deb0ro/ventaxia-esphome/hardware/mvhr_ctrl/J1_pinout_top.png

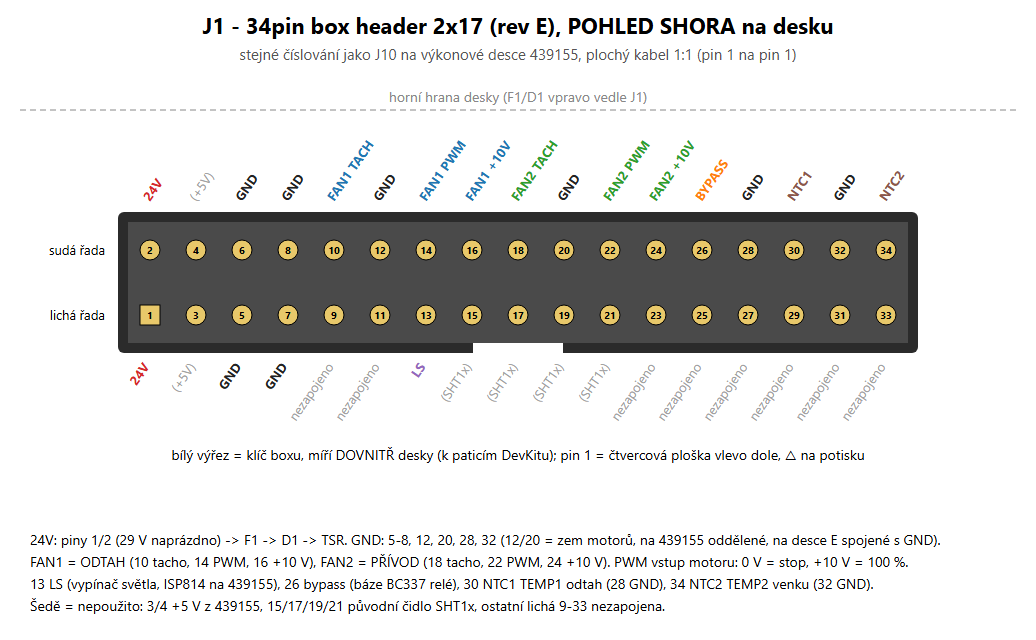
hardware/mvhr_ctrl/J1_pinout_top.png
