deb0ro/ventaxia-esphome/hardware/mvhr_ctrl/render_bottom.png

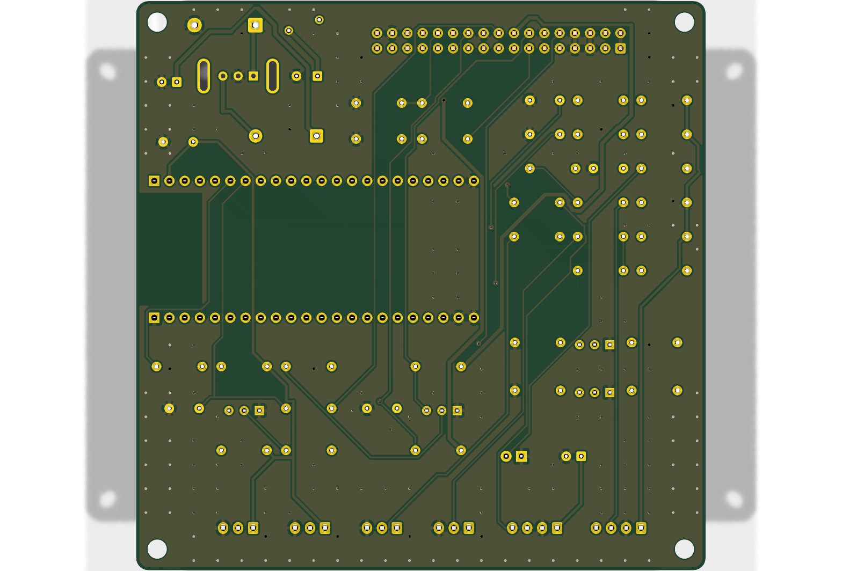
hardware/mvhr_ctrl/render_bottom.png
