deb0ro/ventaxia-esphome/hardware/mvhr_ctrl/mvhr_ctrl_bom.csv

Reference | Value | Footprint | MPN | Qty
C1 | 10u/100V | Capacitor_THT:CP_Radial_D8.0mm_P3.50mm | Electrolytic 10 uF 100 V, D8 P3.5 | 1
C2 | 47u/16V | Capacitor_THT:CP_Radial_D6.3mm_P2.50mm |  | 1
C3,C13-C15 | 100n | Capacitor_THT:C_Disc_D5.0mm_W2.5mm_P5.00mm |  | 4
C5 | 100u/10V | Capacitor_THT:CP_Radial_D6.3mm_P2.50mm |  | 1
C21,C41 | 1n | Capacitor_THT:C_Disc_D5.0mm_W2.5mm_P5.00mm |  | 2
D1 | P6KE47CA | Diode_THT:D_DO-15_P10.16mm_Horizontal | P6KE47CA (40.2 V standoff, 64.8 V clamp) | 1
D2 | 1N5819 | Diode_THT:D_DO-41_SOD81_P10.16mm_Horizontal |  | 1
D3 | red 3 mm | LED_THT:LED_D3.0mm |  | 1
F1 | RXEF030 | Fuse:Fuse_BelFuse_0ZRE0033FF_L11.4mm_W3.8mm | Littelfuse RXEF030 (72 V, hold 0.30 A / trip 0.60 A @ 20 C), alt. Bel Fuse 0ZRE0033FF1A | 1
J1 | IDC 2x17 -> 439155 J10 | Connector_IDC:IDC-Header_2x17_P2.54mm_Vertical | Box header 2x17 2.54mm | 1
J2 | DevKit J1 (left) | Connector_PinSocket_2.54mm:PinSocket_1x22_P2.54mm_Vertical | Female header 1x22 2.54 mm | 1
J3 | DevKit J3 (right) | Connector_PinSocket_2.54mm:PinSocket_1x22_P2.54mm_Vertical | Female header 1x22 2.54 mm | 1
J4 | OUTDOOR | Connector_JST:JST_XH_B3B-XH-A_1x03_P2.50mm_Vertical | JST B3B-XH-A | 1
J5 | SUPPLY | Connector_JST:JST_XH_B3B-XH-A_1x03_P2.50mm_Vertical | JST B3B-XH-A | 1
J6 | EXTRACT | Connector_JST:JST_XH_B3B-XH-A_1x03_P2.50mm_Vertical | JST B3B-XH-A | 1
J7 | EXHAUST | Connector_JST:JST_XH_B3B-XH-A_1x03_P2.50mm_Vertical | JST B3B-XH-A | 1
J8 | Humidity SHT4x (0x44) | Connector_JST:JST_XH_B4B-XH-A_1x04_P2.50mm_Vertical | JST B4B-XH-A | 1
J9 | CO2 SCD41 (0x62) | Connector_JST:JST_XH_B4B-XH-A_1x04_P2.50mm_Vertical | JST B4B-XH-A | 1
Q1-Q4 | PN2222A | Package_TO_SOT_THT:TO-92_Inline_Wide | onsemi PN2222A (TO-92, pins E-B-C = 1-2-3, flat side as on the silkscreen) | 4
R7,R8,R61-R64 | 100 | Resistor_THT:R_Axial_DIN0207_L6.3mm_D2.5mm_P7.62mm_Horizontal |  | 6
R9-R11,R19,R24,R44 | 1k | Resistor_THT:R_Axial_DIN0207_L6.3mm_D2.5mm_P7.62mm_Horizontal |  | 6
R12,R13,R15,R16,R23,R25,R43,R45 | 10k | Resistor_THT:R_Axial_DIN0207_L6.3mm_D2.5mm_P7.62mm_Horizontal |  | 8
R14,R21,R41 | 22k | Resistor_THT:R_Axial_DIN0207_L6.3mm_D2.5mm_P7.62mm_Horizontal |  | 3
R17,R18,R20,R22,R40,R42,R60 | 4k7 | Resistor_THT:R_Axial_DIN0207_L6.3mm_D2.5mm_P7.62mm_Horizontal |  | 7
U1 | TSR 1-4850WI | mvhr_ctrl:TRACO_TSR-1WI_SIP3_CasePins | TRACO TSR 1-4850WI, straight pins (9-72 V in, 5 V 1 A); case pins 4/5 = mechanical, no net | 1
