deb0ro/ventaxia-esphome/hardware/mvhr_ctrl/mvhr_ctrl_assembly.pdf

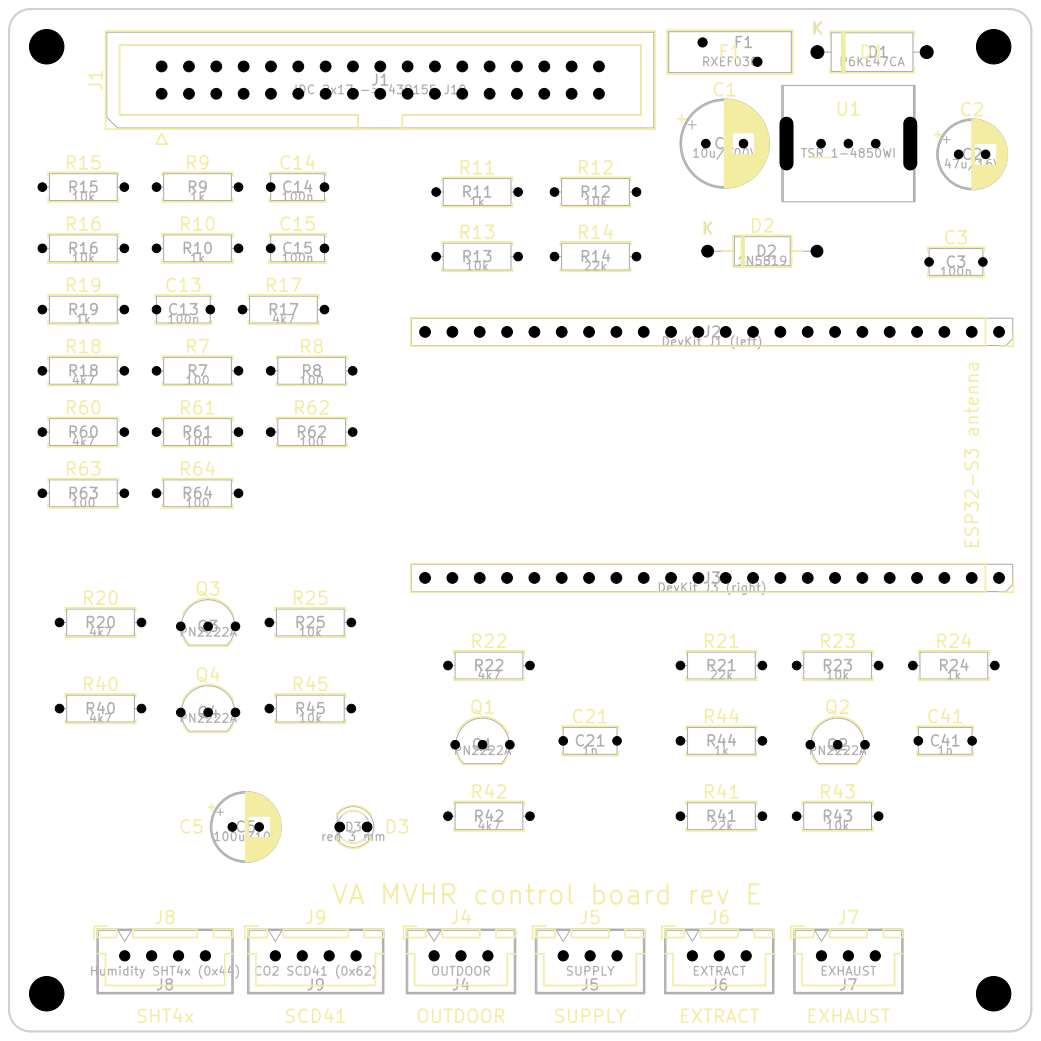
[picture p6: page 1]

VA MVHR control board rev E

Sheet:
File: mvhr_ctrl.kicad_pcb
Title: VA MVHR control board

Size: A4 | Rev: E
KiCad E.D.A. 10.0.7 | Id: 1/1
