deb0ro/ventaxia-esphome/hardware/mvhr_ctrl/mvhr_ctrl.kicad_pcb

## KiCad design hardware/mvhr_ctrl/mvhr_ctrl.kicad_pcb (2026-11-09)

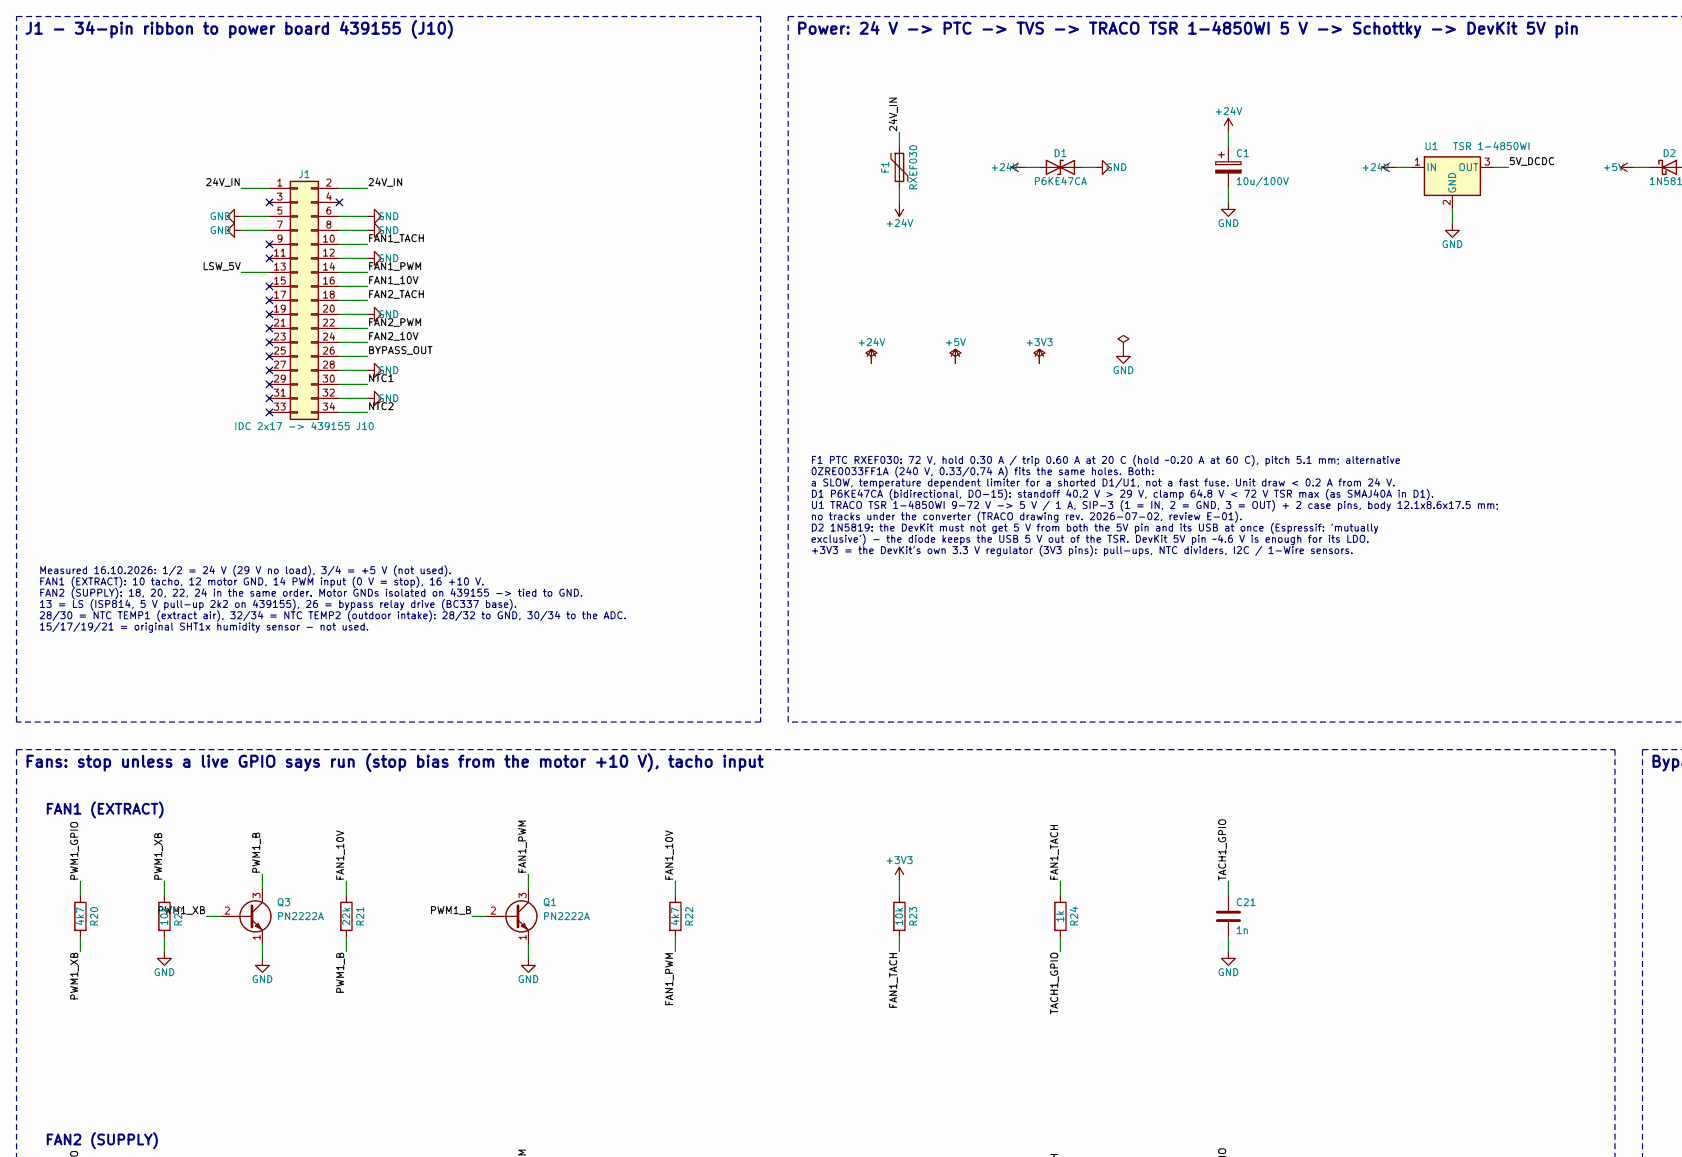
[picture p8: schematic mvhr_ctrl.kicad_sch, MVHR control board - ESP32-S3-DevKitC-1, through-hole, part in row 1, column 1]

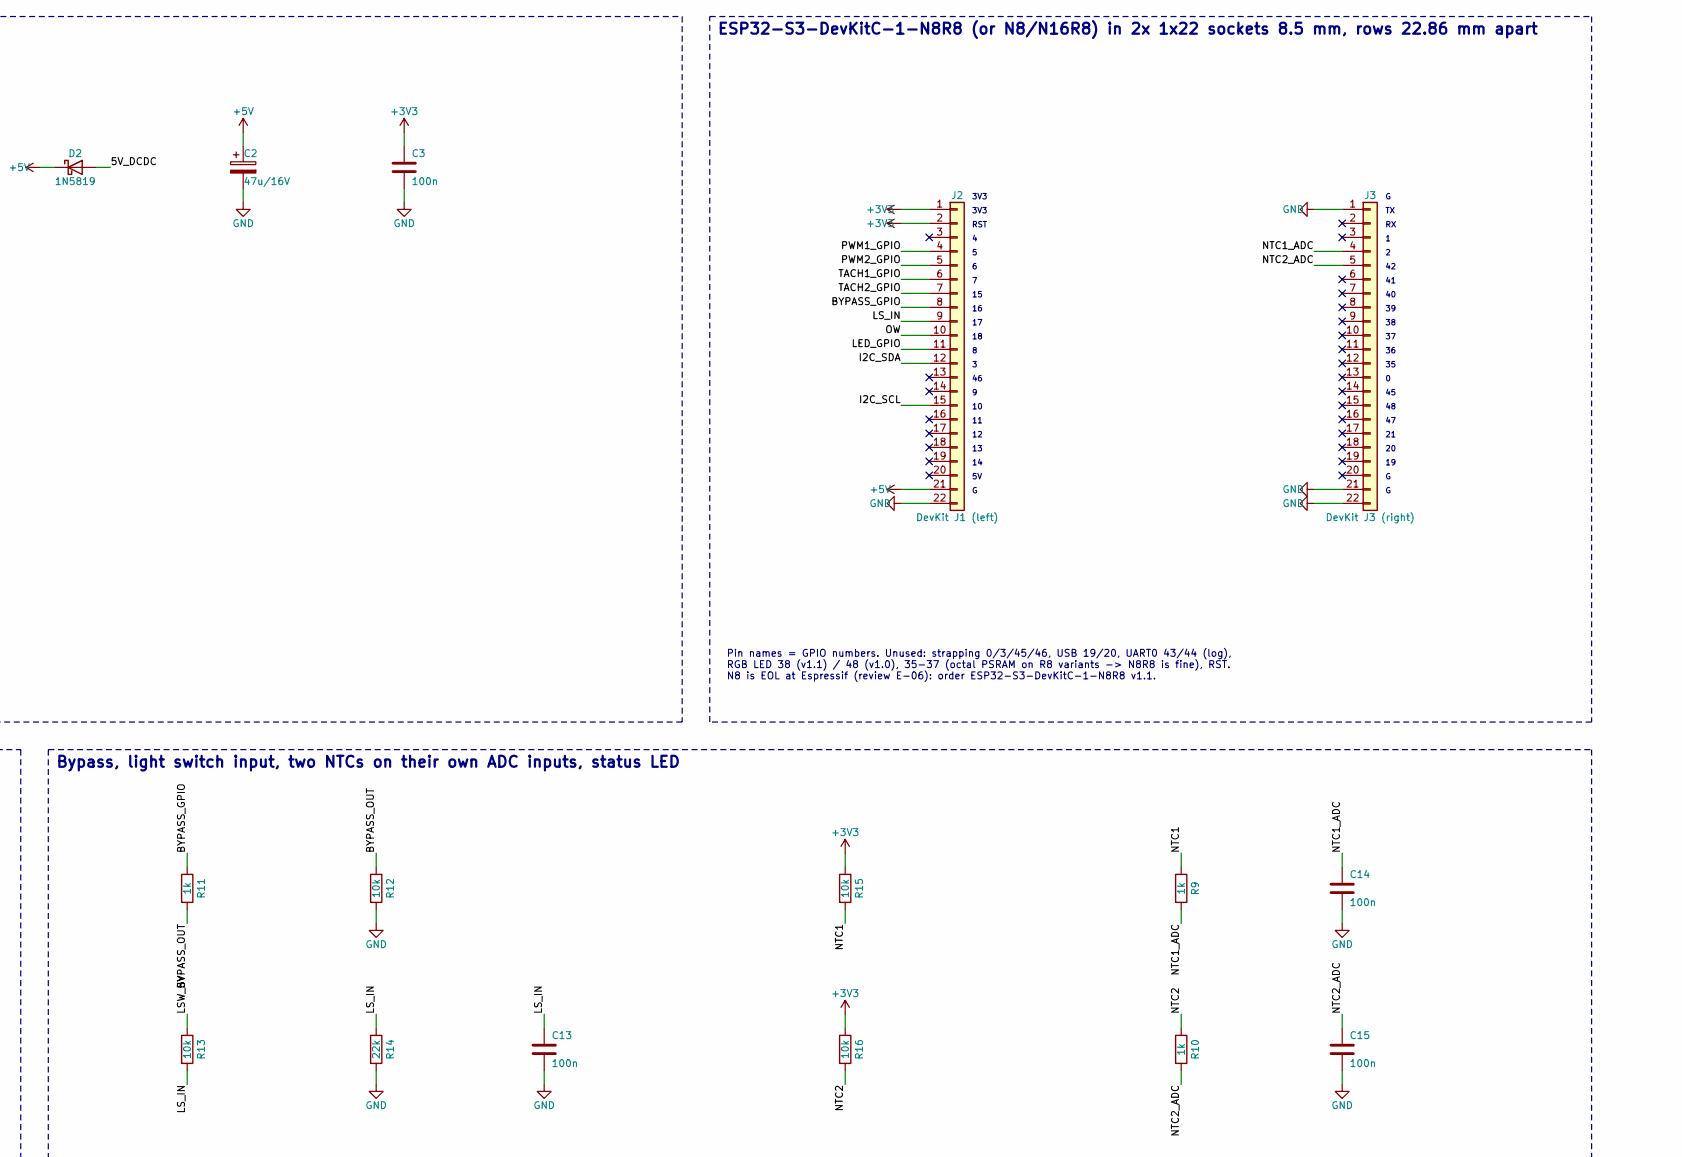
[picture p9: schematic mvhr_ctrl.kicad_sch, MVHR control board - ESP32-S3-DevKitC-1, through-hole, part in row 1, column 2]

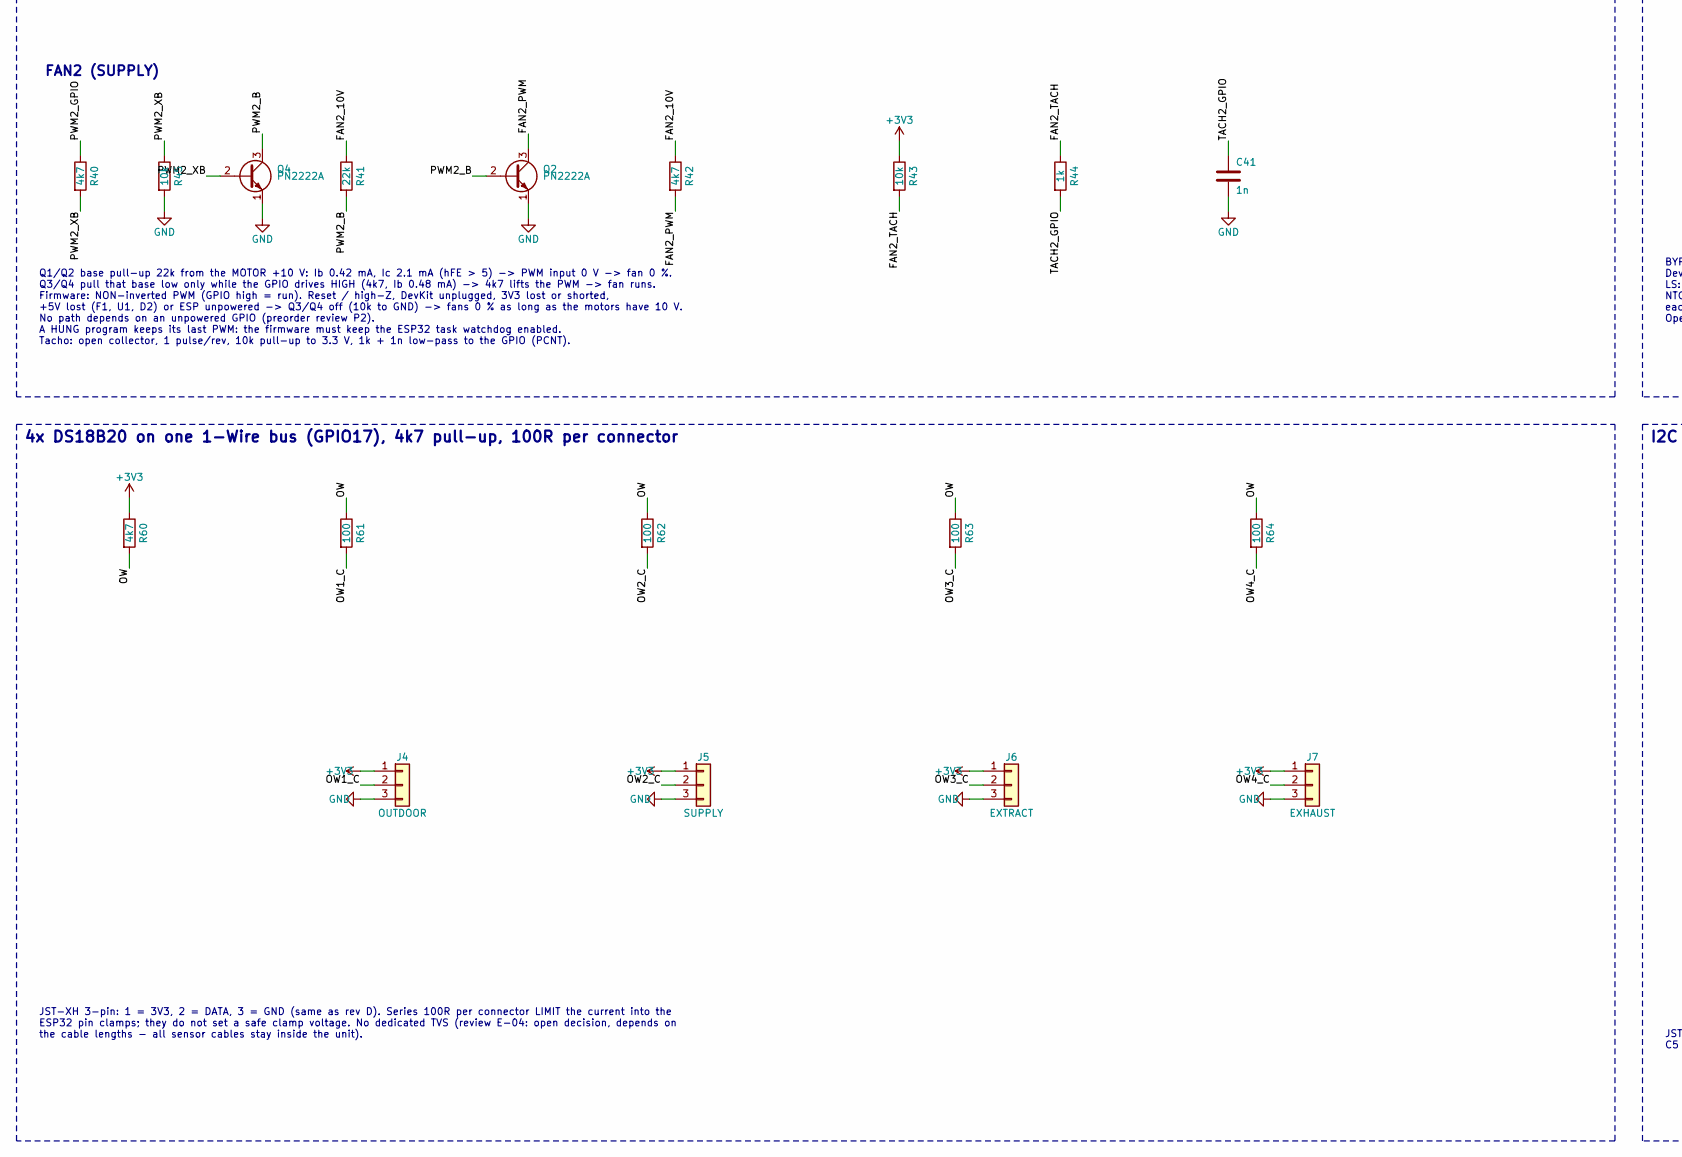
[picture p10: schematic mvhr_ctrl.kicad_sch, MVHR control board - ESP32-S3-DevKitC-1, through-hole, part in row 2, column 1]

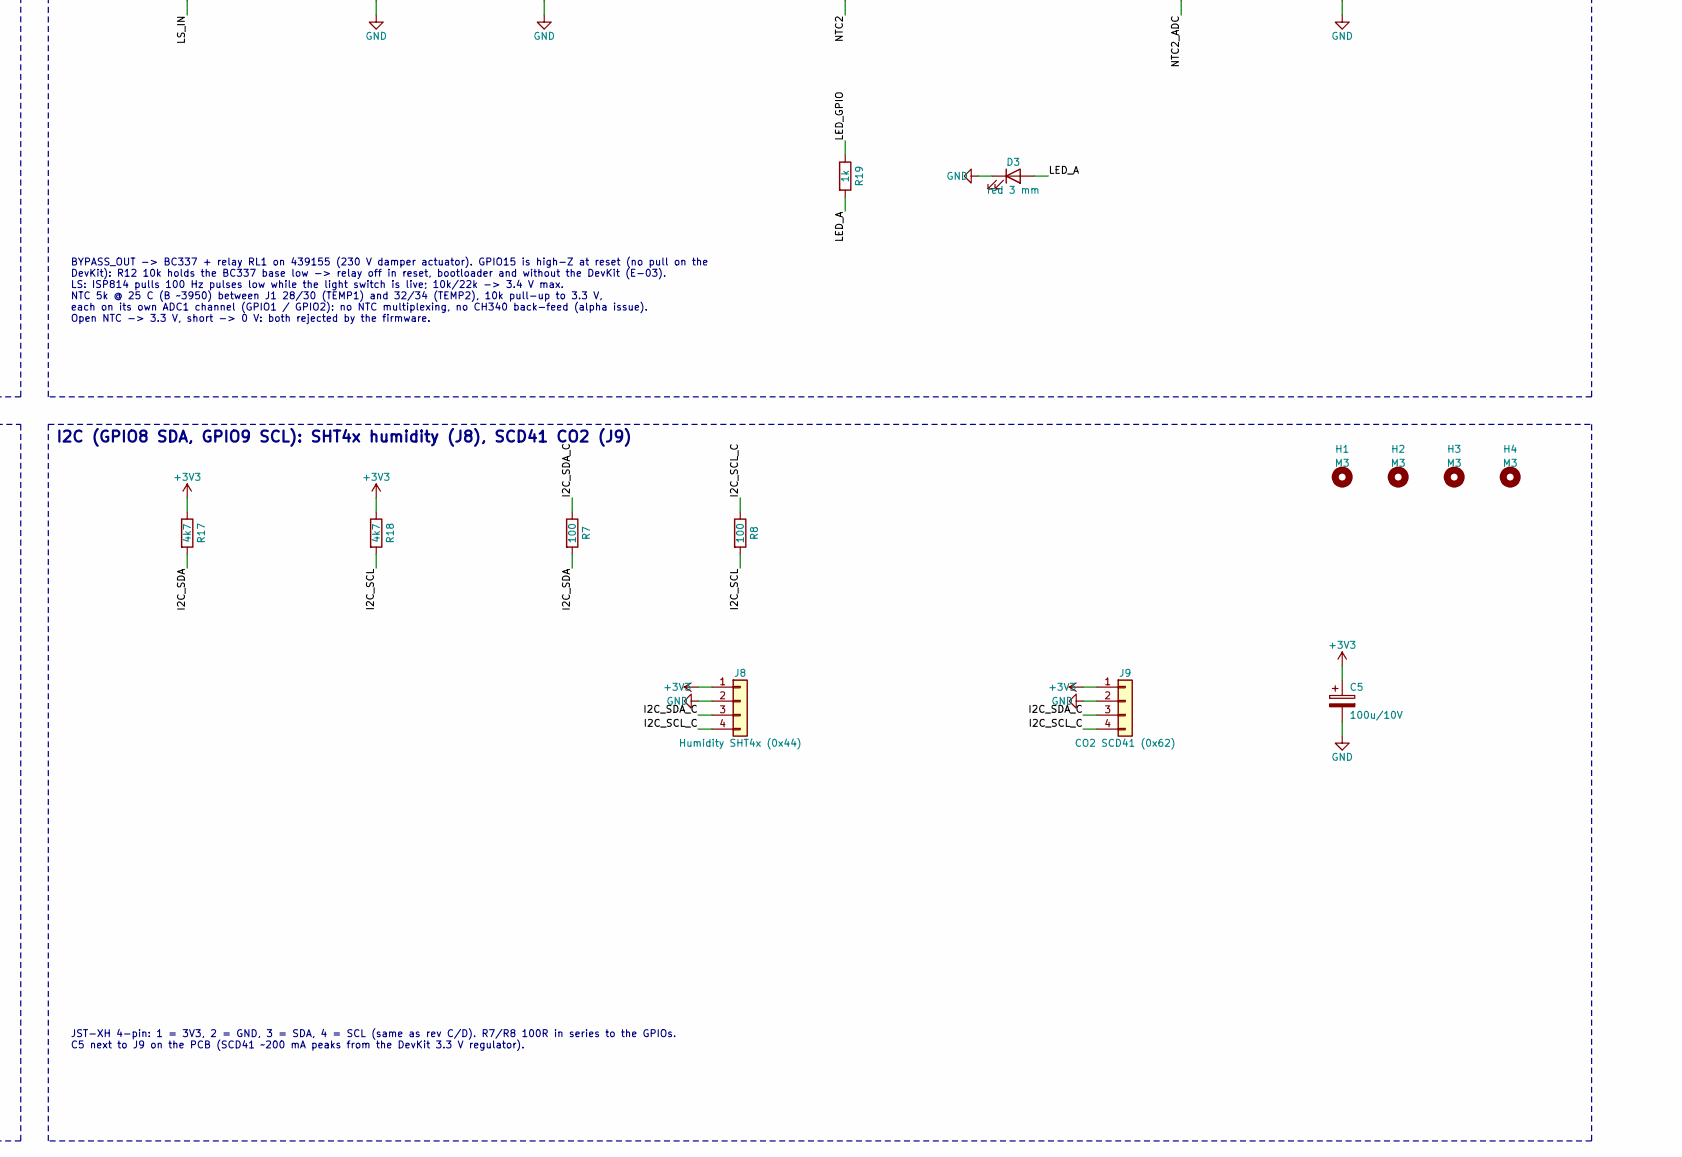
[picture p11: schematic mvhr_ctrl.kicad_sch, MVHR control board - ESP32-S3-DevKitC-1, through-hole, part in row 2, column 2]

Parts:
C1: 10u/100V; CP_Radial_D8.0mm_P3.50mm; MPN Electrolytic 10 uF 100 V, D8 P3.5
C2: 47u/16V; CP_Radial_D6.3mm_P2.50mm
C3, C13, C14, C15: 100n; C_Disc_D5.0mm_W2.5mm_P5.00mm
C5: 100u/10V; CP_Radial_D6.3mm_P2.50mm
C21, C41: 1n; C_Disc_D5.0mm_W2.5mm_P5.00mm
D1: P6KE47CA; D_DO-15_P10.16mm_Horizontal; MPN P6KE47CA (40.2 V standoff, 64.8 V clamp)
D2: 1N5819; D_DO-41_SOD81_P10.16mm_Horizontal
D3: red 3 mm; LED_D3.0mm
F1: RXEF030; Fuse_BelFuse_0ZRE0033FF_L11.4mm_W3.8mm; MPN Littelfuse RXEF030 (72 V, hold 0.30 A /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
H1, H2, H3, H4: M3; MountingHole_3.2mm_M3
J1: IDC 2x17 -> 439155 J10; IDC-Header_2x17_P2.54mm_Vertical; MPN Box header 2x17 2.54mm
J2: DevKit J1 (left); PinSocket_1x22_P2.54mm_Vertical; MPN Female header 1x22 2.54 mm
J3: DevKit J3 (right); PinSocket_1x22_P2.54mm_Vertical; MPN Female header 1x22 2.54 mm
J4: OUTDOOR; JST_XH_B3B-XH-A_1x03_P2.50mm_Vertical; MPN JST B3B-XH-A
J5: SUPPLY; JST_XH_B3B-XH-A_1x03_P2.50mm_Vertical; MPN JST B3B-XH-A
J6: EXTRACT; JST_XH_B3B-XH-A_1x03_P2.50mm_Vertical; MPN JST B3B-XH-A
J7: EXHAUST; JST_XH_B3B-XH-A_1x03_P2.50mm_Vertical; MPN JST B3B-XH-A
J8: Humidity SHT4x (0x44); JST_XH_B4B-XH-A_1x04_P2.50mm_Vertical; MPN JST B4B-XH-A
J9: CO2 SCD41 (0x62); JST_XH_B4B-XH-A_1x04_P2.50mm_Vertical; MPN JST B4B-XH-A
Q1, Q2, Q3, Q4: PN2222A; TO-92_Inline_Wide; MPN onsemi PN2222A (TO-92, pins E-B-C = 1-2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
R7, R8, R61, R62, R63, R64: 100; R_Axial_DIN0207_L6.3mm_D2.5mm_P7.62mm_Horizontal
R9, R10, R11, R19, R24, R44: 1k; R_Axial_DIN0207_L6.3mm_D2.5mm_P7.62mm_Horizontal
R12, R13, R15, R16, R23, R25, R43, R45: 10k; R_Axial_DIN0207_L6.3mm_D2.5mm_P7.62mm_Horizontal
R14, R21, R41: 22k; R_Axial_DIN0207_L6.3mm_D2.5mm_P7.62mm_Horizontal
R17, R18, R20, R22, R40, R42, R60: 4k7; R_Axial_DIN0207_L6.3mm_D2.5mm_P7.62mm_Horizontal
U1: TSR 1-4850WI; TRACO_TSR-1WI_SIP3_CasePins; MPN TRACO TSR 1-4850WI, straight pins (9-72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

Connections:
+3V3: C3.1, C5.1, J2.1, J2.2, J4.1, J5.1, J6.1, J7.1, J8.1, J9.1, R15.1, R16.1, R17.1, R18.1, R23.1, R43.1, R60.1
+5V: C2.1, D2.1 (K), J2.21
+24V: C1.1, D1.1 (A1), F1.2, U1.1 (IN)
/5V_DCDC: D2.2 (A), U1.3 (OUT)
/24V_IN: F1.1, J1.1, J1.2
/BYPASS_GPIO: J2.8, R11.1
/BYPASS_OUT: J1.26, R11.2, R12.1
/FAN1_10V: J1.16, R21.1, R22.1
/FAN1_PWM: J1.14, Q1.3 (C), R22.2
/FAN1_TACH: J1.10, R23.2, R24.1
/FAN2_10V: J1.24, R41.1, R42.1
/FAN2_PWM: J1.22, Q2.3 (C), R42.2
/FAN2_TACH: J1.18, R43.2, R44.1
/I2C_SCL: J2.15, R8.2, R18.2
/I2C_SCL_C: J8.4, J9.4, R8.1
/I2C_SDA: J2.12, R7.2, R17.2
/I2C_SDA_C: J8.3, J9.3, R7.1
/LED_A: D3.2 (A), R19.2
/LED_GPIO: J2.11, R19.1
/LSW_5V: J1.13, R13.1
/LS_IN: C13.1, J2.9, R13.2, R14.1
/NTC1: J1.30, R9.1, R15.2
/NTC1_ADC: C14.1, J3.4, R9.2
/NTC2: J1.34, R10.1, R16.2
/NTC2_ADC: C15.1, J3.5, R10.2
/OW: J2.10, R60.2, R61.1, R62.1, R63.1, R64.1
/OW1_C: J4.2, R61.2
/OW2_C: J5.2, R62.2
/OW3_C: J6.2, R63.2
/OW4_C: J7.2, R64.2
/PWM1_B: Q1.2 (B), Q3.3 (C), R21.2
/PWM1_GPIO: J2.4, R20.1
/PWM1_XB: Q3.2 (B), R20.2, R25.1
/PWM2_B: Q2.2 (B), Q4.3 (C), R41.2
/PWM2_GPIO: J2.5, R40.1
/PWM2_XB: Q4.2 (B), R40.2, R45.1
/TACH1_GPIO: C21.1, J2.6, R24.2
/TACH2_GPIO: C41.1, J2.7, R44.2
GND: C1.2, C2.2, C3.2, C5.2, C13.2, C14.2, C15.2, C21.2, C41.2, D1.2 (A2), D3.1 (K), J1.5, J1.6, J1.7, J1.8, J1.12, J1.20, J1.28, J1.32, J2.22, J3.1, J3.21, J3.22, J4.3, J5.3, J6.3, J7.3, J8.2, J9.2, Q1.1 (E), Q2.1 (E), Q3.1 (E), Q4.1 (E), R12.2, R14.2, R25.2, R45.2, U1.2 (GND)

Notes on the sheet:
J1 - 34-pin ribbon to power board 439155 (J10)
Measured 16.10.2026: 1/2 = 24 V (29 V no load), 3/4 = +5 V (not used). FAN1 (EXTRACT): 10 tacho, 12 motor GND, 14 PWM input (0 V = stop), 16 +10 V. FAN2 (SUPPLY): 18, 20, 22, 24 in the same order. Motor GNDs isolated on 439155 -> tied to GND. 13 = LS (ISP814, 5 V pull-up 2k2 on 439155), 26 = bypass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
Power: 24 V -> PTC -> TVS -> TRACO TSR 1-4850WI 5 V -> Schottky -> DevKit 5V pin
F1 PTC RXEF030: 72 V, hold 0.30 A / trip 0.60 A at 20 C (hold ~0.20 A at 60 C), pitch 5.1 mm; alternative 0ZRE0033FF1A (240 V, 0.33/0.74 A) fits the same holes. Both: a SLOW, temperature dependent limiter for a shorted D1/U1, not a fast fuse. Unit draw < 0.2 A from 24 V. D1 P6KE47CA (bidirectional,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
ESP32-S3-DevKitC-1-N8R8 (or N8/N16R8) in 2x 1x22 sockets 8.5 mm, rows 22.86 mm apart
3V3
RST
Pin names = GPIO numbers. Unused: strapping 0/3/45/46, USB 19/20, UART0 43/44 (log), RGB LED 38 (v1.1) / 48 (v1.0), 35-37 (octal PSRAM on R8 variants -> N8R8 is fine), RST. N8 is EOL at Espressif (review E-06): order ESP32-S3-DevKitC-1-N8R8 v1.1.
Fans: stop unless a live GPIO says run (stop bias from the motor +10 V), tacho input
FAN1 (EXTRACT)
FAN2 (SUPPLY)
Q1/Q2 base pull-up 22k from the MOTOR +10 V: Ib 0.42 mA, Ic 2.1 mA (hFE > 5) -> PWM input 0 V -> fan 0 %. Q3/Q4 pull that base low only while the GPIO drives HIGH (4k7, Ib 0.48 mA) -> 4k7 lifts the PWM -> fan runs. Firmware: NON-inverted PWM (GPIO high = run). Reset / high-Z, DevKit unplugged, 3V3 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
Bypass, light switch input, two NTCs on their own ADC inputs, status LED
BYPASS_OUT -> BC337 + relay RL1 on 439155 (230 V damper actuator). GPIO15 is high-Z at reset (no pull on the DevKit): R12 10k holds the BC337 base low -> relay off in reset, bootloader and without the DevKit (E-03). LS: ISP814 pulls 100 Hz pulses low while the light switch is live; 10k/22k -> 3.4 V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
4x DS18B20 on one 1-Wire bus (GPIO17), 4k7 pull-up, 100R per connector
JST-XH 3-pin: 1 = 3V3, 2 = DATA, 3 = GND (same as rev D). Series 100R per connector LIMIT the current into the ESP32 pin clamps; they do not set a safe clamp voltage. No dedicated TVS (review E-04: open decision, depends on the cable lengths - all sensor cables stay inside the unit).
I2C (GPIO8 SDA, GPIO9 SCL): SHT4x humidity (J8), SCD41 CO2 (J9)
JST-XH 4-pin: 1 = 3V3, 2 = GND, 3 = SDA, 4 = SCL (same as rev C/D). R7/R8 100R in series to the GPIOs. C5 next to J9 on the PCB (SCD41 ~200 mA peaks from the DevKit 3.3 V regulator).

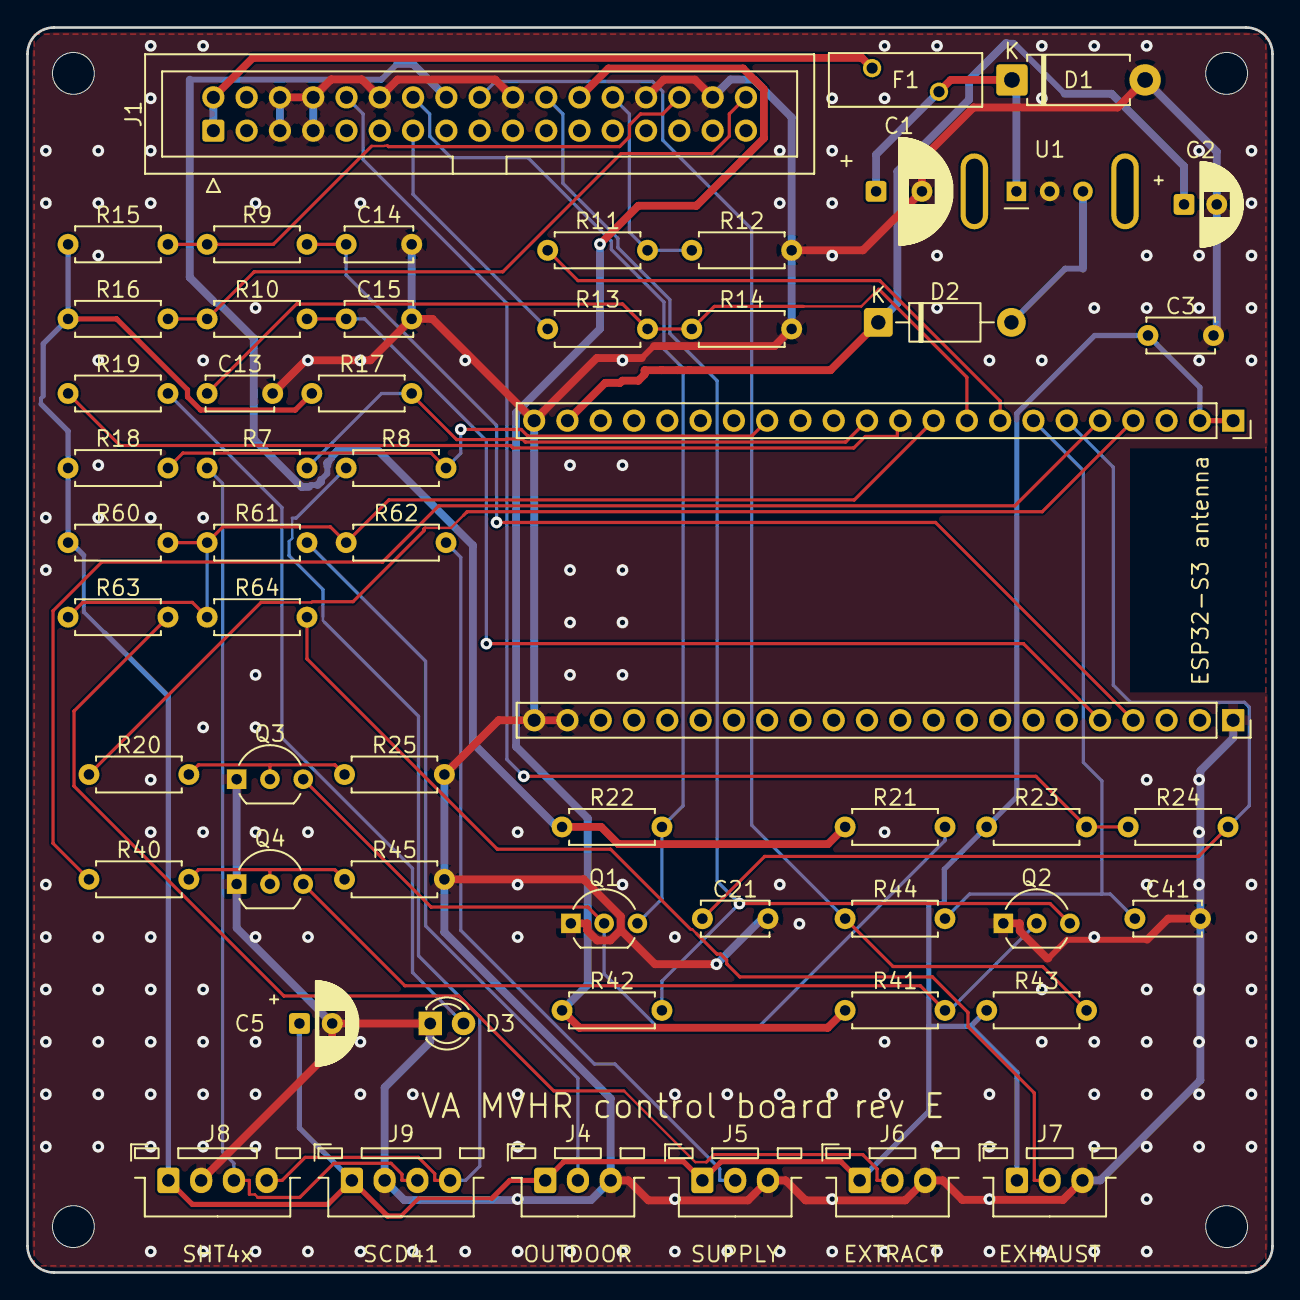
[picture p12: board mvhr_ctrl.kicad_pcb from above]

Board: 2 copper layers, 95.0 x 95.0 mm, 61 parts (0 on the bottom side), 39 nets.
