deb0ro/ventaxia-esphome/firmware/gen/reve.py

# Rev E hardware layer for gen_fw.py: turns the shared template (control logic of the alpha, all review fixes)
# into hw/firmware/ventaxia_reve.yaml for the MVHR control board rev E (hw/mvhr_ctrl, ESP32-S3-DevKitC-1-N8R8).
# Only the hardware differs; every replacement must match exactly (count given), so a template change that breaks
# one of them stops the generator instead of producing a silently wrong firmware.

# extra settings of rev E: switch id, (cfg byte, bit), HA name, default, icon, config category
SWS_EXTRA = [
    ('ls_boost', (84, 3), 'Light switch boost', 1, 'mdi:lightbulb-on-outline', True),
]

HEADER = '''# MVHR control board REV E: ESP32-S3-DevKitC-1-N8R8 in sockets (hw/mvhr_ctrl), replaces control board 439150.
# Connects to J10 of power board 439155 with the 34-pin ribbon. Schematic: hw/mvhr_ctrl/mvhr_ctrl_schematic.pdf.
# Control logic runs ON THE ESP (hw/REKUPERACE.md): Home Assistant only changes the mode / parameters and shows
# the state. Without HA (or Wi-Fi) the unit keeps running with the last settings (stored in flash).
# GENERATED by hw/firmware/gen/gen_fw.py from gen/fw_template.yaml (logic shared with the alpha) + gen/reve.py
# (rev E hardware) - edit those, not this file.
#
# Pin map (DevKit GPIO):
#   GPIO4   FAN1 PWM (EXTRACT)  -> R20 4k7 -> Q3 -> Q1 -> J10 pin 14     NON-inverted: GPIO high = fan runs
#   GPIO5   FAN2 PWM (SUPPLY)   -> R40 4k7 -> Q4 -> Q2 -> J10 pin 22
#           Q1/Q2 are biased ON from the motor +10 V (R21/R41 22k) = PWM line low = STOP whenever the GPIO is low,
#           floating (reset, flashing), the DevKit is unplugged or the 3V3 / 5V of this board is lost.
#           NEVER make the PWM outputs inverted (the alpha had them inverted): it would swap stop and full speed.
#   GPIO6   FAN1 tacho  <- J10 pin 10 (10k pull-up to 3V3, 1k + 1n), PCNT
#   GPIO7   FAN2 tacho  <- J10 pin 18
#   GPIO15  bypass      -> R11 1k -> J10 pin 26 (BC337 + relay RL1 on 439155), R12 10k pull-down = off in reset
#   GPIO16  LS input    <- J10 pin 13 (ISP814 on 439155: 100 Hz low pulses while the light switch is live)
#   GPIO1   NTC1 TEMP1 (extract air)  ADC1_CH0, 10k pull-up to 3V3, NTC to GND, 1k + 100n
#   GPIO2   NTC2 TEMP2 (outdoor)      ADC1_CH1
#   GPIO17  1-Wire: 4x DS18B20 (J4 OUTDOOR, J5 SUPPLY, J6 EXTRACT, J7 EXHAUST), 4k7 pull-up
#   GPIO8/9 I2C SDA/SCL: SHT4x 0x44 (J8), SCD41 0x62 (J9), 4k7 pull-ups, 100R in series
#   GPIO18  LED D3 (status_led: off = OK, blinking = warning / error)
# Watchdog: ESPHome on ESP32 subscribes its main loop to the ESP-IDF task watchdog - a hung program resets the chip,
# the GPIOs float and the fans STOP (hardware default). Keep it that way (review E-02).
# DS18B20 addresses: unknown until the sensors are wired. After the first flash the log lists the found devices
# ("one_wire ... Found devices: 0x..."); put them into the ds_* substitutions and regenerate. A missing / zero
# address only gives NAN for that sensor.
# First version for rev E (18.10.2026): the control is the alpha one; DS18B20 EXTRACT / OUTDOOR back up TEMP1 /
# TEMP2 before the HA values, the SHT4x backs up the HA humidity for the dry air protection, the light switch
# input boosts. CO2 / humidity demand control is not active yet (sensors are only published).
'''

PAIRS = [
    # ---------------------------------------------------------------- substitutions, device
    ('  fil_fresh_ms: "900000UL"     # filter deviation counts (text + alarm) only with a sample in the last 15 min\n',
     '''  fil_fresh_ms: "900000UL"     # filter deviation counts (text + alarm) only with a sample in the last 15 min
  ds_outdoor: "0x0000000000000001"   # DS18B20 addresses from the log after the first flash (see the header)
  ds_supply: "0x0000000000000002"
  ds_extract: "0x0000000000000003"
  ds_exhaust: "0x0000000000000004"
''', 1),
    ('  name: ventaxia-alpha\n', '  name: ventaxia-reve\n', 1),
    ('''esp8266:
  board: nodemcuv2
  restore_from_flash: true      # the settings record survives a power cut
''', '''esp32:
  board: esp32-s3-devkitc-1
  variant: esp32s3
  flash_size: 8MB               # N8R8; the octal PSRAM (GPIO35-37) is not used
  framework:
    type: esp-idf
''', 1),
    ('''logger:
  baud_rate: 0                  # UART off: TX (GPIO1) drives NTC2
''', '''logger:                         # USB / UART log free on rev E (no pin shared with the NTCs)
''', 1),
    ('  use_address: 192.168.10.201   # the ESPHome Builder does not find the board via mDNS; keep a DHCP reservation\n',
     '  # use_address: 192.168.10.x   # set once the board has a DHCP reservation (the Builder had no mDNS on the alpha)\n', 1),
    ('    ssid: "ventaxia-alpha"\n', '    ssid: "ventaxia-reve"\n', 1),
    # ---------------------------------------------------------------- outputs
    ('''output:
  # inverted: level 1.0 = GPIO low = transistor off = PWM line pulled to motor +10 V = 100 %
  - platform: esp8266_pwm
    id: fan1_pwm                # EXTRACT
    pin: GPIO14
    frequency: ${pwm_freq}
    inverted: true
  - platform: esp8266_pwm
    id: fan2_pwm                # SUPPLY
    pin: GPIO13
    frequency: ${pwm_freq}
    inverted: true
''', '''output:
  # rev E: NON-inverted. Level 1.0 = GPIO high = Q3/Q4 on = Q1/Q2 off = PWM line pulled to motor +10 V = 100 %
  - platform: ledc
    id: fan1_pwm                # EXTRACT
    pin: GPIO4
    frequency: ${pwm_freq}
  - platform: ledc
    id: fan2_pwm                # SUPPLY
    pin: GPIO5
    frequency: ${pwm_freq}

status_led:
  pin: GPIO18                   # D3: off = OK, blinking = warning / error

one_wire:
  - platform: gpio
    pin: GPIO17

i2c:
  sda: GPIO8
  scl: GPIO9
  frequency: 100kHz             # 100R series resistors + cables: stay slow
''', 1),
    # ---------------------------------------------------------------- globals
    ('''  - id: ntc_active              # 1 = NTC1 powered, 2 = NTC2 powered, 0 = none
    type: int
    initial_value: "0"
  - id: ntc_va                  # A0 volts with NTC1 powered (NTC2 at 0 V)
    type: float
    initial_value: "0"
  - id: ntc_vb                  # A0 volts with NTC2 powered (NTC1 at 0 V)
    type: float
    initial_value: "0"
''', '''  - id: ds_ext_ms               # millis() of the last valid DS18B20 EXTRACT / OUTDOOR reading (backup of TEMP1/2)
    type: uint32_t
    initial_value: "0"
  - id: ds_out_ms
    type: uint32_t
    initial_value: "0"
  - id: sht_ms                  # millis() of the last valid SHT4x humidity (backup of the HA humidity)
    type: uint32_t
    initial_value: "0"
''', 1),
    ('''    pin: GPIO4
    restore_mode: ALWAYS_OFF
''', '''    pin: GPIO15
    restore_mode: ALWAYS_OFF
''', 1),
    # ---------------------------------------------------------------- control: backups and the light switch
    ('''          bool ext_ok = t1_ok, ext_ha = false;
          if (!t1_ok && api_ok''', '''          bool ext_ok = t1_ok, ext_ha = false, ext_ds = false;
          if (!ext_ok && temp_ok(id(ds_extract).state) && fresh(id(ds_ext_ms), 120000UL)) {   // DS18B20 EXTRACT
            t_ext = id(ds_extract).state; ext_ok = true; ext_ds = true;
          }
          if (!ext_ok && api_ok''', 1),
    ('''          bool out_ok = t2_ok, out_ha = false;
          if (!t2_ok && api_ok''', '''          bool out_ok = t2_ok, out_ha = false, out_ds = false;
          if (!out_ok && temp_ok(id(ds_outdoor).state) && fresh(id(ds_out_ms), 120000UL)) {   // DS18B20 OUTDOOR
            t_out = id(ds_outdoor).state; out_ok = true; out_ds = true;
          }
          if (!out_ok && api_ok''', 1),
    ('''          const bool boost = id(boost_end) != 0 && (int32_t) (id(boost_end) - now) > 0;''',
     '''          const bool ls = id(ls_boost).state && id(ls_in).state;          // light switch held on
          const bool boost = ls || (id(boost_end) != 0 && (int32_t) (id(boost_end) - now) > 0);''', 1),
    ('''why = boost ? "Boost (timer)" : "Boost"; }''',
     '''why = ls ? "Boost (light switch)" : boost ? "Boost (timer)" : "Boost"; }''', 1),
    ('''            const float rh = id(indoor_rh).state;
            const bool rh_ok = api_ok && !std::isnan(rh) && rh > 5.0f && rh < 100.0f && fresh(id(rh_ms), ${ha_max_age_ms});''',
     '''            float rh = id(indoor_rh).state;
            bool rh_ok = api_ok && !std::isnan(rh) && rh > 5.0f && rh < 100.0f && fresh(id(rh_ms), ${ha_max_age_ms});
            if (!rh_ok) {                                  // local SHT4x when the HA humidity is missing
              rh = id(sht_rh).state;
              rh_ok = std::isfinite(rh) && rh > 5.0f && rh < 100.0f && fresh(id(sht_ms), 300000UL);
            }''', 1),
    ('''          if (!t1_ok) why += ext_ha ? ", TEMP1 fault (house temperature from HA)" : (ext_ok ? "" : ", TEMP1 fault");
          if (!t2_ok) why += out_ha ? ", TEMP2 fault (outdoor from HA)" : ", TEMP2 fault";''',
     '''          if (!t1_ok) why += ext_ds ? ", TEMP1 fault (DS18B20 EXTRACT)"
                           : ext_ha ? ", TEMP1 fault (house temperature from HA)" : ", TEMP1 fault";
          if (!t2_ok) why += out_ds ? ", TEMP2 fault (DS18B20 OUTDOOR)"
                           : out_ha ? ", TEMP2 fault (outdoor from HA)" : ", TEMP2 fault";''', 1),
    # ---------------------------------------------------------------- tacho (PCNT glitch filter max ~12.8 us)
    ('''      number: GPIO12
      mode: INPUT''', '''      number: GPIO6
      mode: INPUT''', 1),
    ('''      number: GPIO5
      mode: INPUT''', '''      number: GPIO7
      mode: INPUT''', 1),
    ('    internal_filter: 50us\n', '    internal_filter: 10us       # ESP32 PCNT filter max ~12.8 us; the 1k + 1n RC does the rest\n', 2),
    # ---------------------------------------------------------------- binary sensors
    ('binary_sensor:\n', '''binary_sensor:
  - platform: gpio
    id: ls_in
    name: "Light switch"
    icon: mdi:lightbulb
    pin:
      number: GPIO16
      mode: INPUT               # 10k/22k divider from the ISP814 output on 439155, idle high
      inverted: true            # live switch = 100 Hz low pulses
    filters:
      - delayed_off: 60ms       # bridge the gaps between the mains pulses
      - delayed_on: 500ms       # ignore spikes
    on_state:
      - lambda: |-
          // boost while on is done by the control script; here only the overrun after a real on -> off change
          // (not on the first state published after boot)
          static int prev = -1;
          if (prev == 1 && !x && id(ls_boost).state) {
            id(boost_end) = millis() + (uint32_t) (id(boost_minutes).state * 60000.0f);
            if (id(boost_end) == 0) id(boost_end) = 1;
          }
          prev = x ? 1 : 0;
      - script.execute: control
''', 1),
]

NTC_INTERVAL = '''  # NTCs (rev E): each on its own ADC1 input, 10k pull-up to 3.3 V, NTC to GND, 1k + 100n -> R = 10k V / (3.3 - V).
  # A reading counts as valid (t1_ok_ms / t2_ok_ms) only when R is plausible: 500 Ohm .. 150 kOhm (~+90 .. -40 C).
  # Open NTC -> ~3.3 V (above the ADC range), short -> 0 V: both rejected.
  - interval: ${ntc_interval}
    then:
      - component.update: ntc1_adc
      - component.update: ntc2_adc
      - delay: 100ms
      - lambda: |-
          const float vs = 3.3f, rp = 10000.0f;
          auto res = [vs, rp](float v) { return (std::isfinite(v) && v > 0.02f && v < vs - 0.05f) ? rp * v / (vs - v) : NAN; };
          const float r1 = res(id(ntc1_adc).state), r2 = res(id(ntc2_adc).state);
          const bool g1 = std::isfinite(r1) && r1 > 500.0f && r1 < 150000.0f;
          const bool g2 = std::isfinite(r2) && r2 > 500.0f && r2 < 150000.0f;
          if (g1) id(t1_ok_ms) = millis();
          if (g2) id(t2_ok_ms) = millis();
          id(ntc1_r).publish_state(g1 ? r1 : NAN);
          id(ntc2_r).publish_state(g2 ? r2 : NAN);
'''

ADC = '''  # --- NTC readout: two ADC1 channels (rev E)
  - platform: adc
    id: ntc1_adc
    pin: GPIO1
    attenuation: 12db           # 0 .. ~3.1 V
    update_interval: never
    internal: true
  - platform: adc
    id: ntc2_adc
    pin: GPIO2
    attenuation: 12db
    update_interval: never
    internal: true
'''

SENSORS = '''
  # --- rev E: 4x DS18B20 on the 1-Wire bus (addresses: substitutions, see the header)
  - platform: dallas_temp
    id: ds_outdoor
    address: ${ds_outdoor}
    name: "Outdoor air temperature (DS18B20)"
    update_interval: 30s
    on_value:
      - lambda: if (std::isfinite(x) && x > -40.0f && x < 70.0f) id(ds_out_ms) = millis();
  - platform: dallas_temp
    id: ds_supply
    address: ${ds_supply}
    name: "Supply air temperature (DS18B20)"
    update_interval: 30s
  - platform: dallas_temp
    id: ds_extract
    address: ${ds_extract}
    name: "Extract air temperature (DS18B20)"
    update_interval: 30s
    on_value:
      - lambda: if (std::isfinite(x) && x > -40.0f && x < 70.0f) id(ds_ext_ms) = millis();
  - platform: dallas_temp
    id: ds_exhaust
    address: ${ds_exhaust}
    name: "Exhaust air temperature (DS18B20)"
    update_interval: 30s
  - platform: template
    name: "Heat recovery efficiency"
    icon: mdi:heat-wave
    unit_of_measurement: "%"
    accuracy_decimals: 0
    update_interval: 60s
    lambda: |-
      // supply-side efficiency (supply - outdoor) / (extract - outdoor); only with the bypass closed and a
      // meaningful temperature difference, otherwise NAN
      const float o = id(ds_outdoor).state, s = id(ds_supply).state, e = id(ds_extract).state;
      if (!std::isfinite(o) || !std::isfinite(s) || !std::isfinite(e) || id(bypass_relay).state) return NAN;
      if (fabsf(e - o) < 5.0f) return NAN;
      return std::min(110.0f, std::max(-10.0f, (s - o) * 100.0f / (e - o)));

  # --- rev E: I2C sensors (a missing sensor only marks its component failed)
  - platform: sht4x
    temperature:
      name: "SHT4x temperature"
    humidity:
      id: sht_rh
      name: "SHT4x humidity"
      on_value:
        - lambda: if (std::isfinite(x) && x > 5.0f && x < 100.0f) id(sht_ms) = millis();
    update_interval: 30s
  - platform: scd4x
    co2:
      name: "CO2"
    temperature:
      name: "SCD41 temperature"
      entity_category: diagnostic
    humidity:
      name: "SCD41 humidity"
      entity_category: diagnostic
    update_interval: 60s
'''


def transform(t):
    i = t.index('#\n# Settings storage')
    t = HEADER + t[i:]
    for a, b, n in PAIRS:
        assert t.count(a) == n, ('reve: %d x expected' % n, a[:80])
        t = t.replace(a, b)
    a = t.index('  # Read the two NTCs through the single ADC.')
    b = t.index('          id(ntc2_r).publish_state(g2 ? r2 : NAN);\n') + len('          id(ntc2_r).publish_state(g2 ? r2 : NAN);\n')
    t = t[:a] + NTC_INTERVAL + t[b:]
    a = t.index('  # --- NTC readout: one ADC')
    end = '          else if (id(ntc_active) == 2) id(ntc_vb) = x;\n'
    b = t.index(end) + len(end)
    t = t[:a] + ADC + t[b:]
    end = '''  - platform: wifi_signal
    name: "WiFi signal"
    update_interval: 60s
'''
    assert t.endswith(end), 'reve: template must end with the wifi_signal sensor'
    t = t + SENSORS
    for bad in ('esp8266_pwm', 'nodemcu', 'GPIO14', 'GPIO13', 'GPIO12', 'ntc_active', 'pinMode', 'digitalWrite', 'A0\n'):
        assert bad not in t, ('reve: alpha hardware left', bad)
    assert t.count('inverted: true') == 1, 'reve: only the LS input may be inverted (PWM is NON-inverted on rev E)'
    return t
