deb0ro/ventaxia-esphome/hardware/tools/sexp.py

"""Minimal S-expression reader/writer for KiCad files."""
import re

_TOKEN = re.compile(r'\s*(?:(\()|(\))|("(?:[^"\\]|\\.)*")|([^\s()"]+))')


class Sym(str):
    """Bare (unquoted) atom."""


def _unescape(s):
    return re.sub(r"\\(.)", lambda m: "\n" if m.group(1) == "n" else m.group(1), s)


def parse(text):
    stack = [[]]
    pos = 0
    n = len(text)
    while pos < n:
        m = _TOKEN.match(text, pos)
        if not m:
            if text[pos:].strip() == "":
                break
            raise ValueError("parse error at %d" % pos)
        pos = m.end()
        lp, rp, qs, atom = m.groups()
        if lp:
            stack.append([])
        elif rp:
            item = stack.pop()
            stack[-1].append(item)
        elif qs is not None:
            stack[-1].append(_unescape(qs[1:-1]) if "\\" in qs else qs[1:-1])
        elif atom is not None:
            stack[-1].append(Sym(atom))
    return stack[0][0]


def q(s):
    s = str(s).replace("\\", "\\\\").replace('"', '\\"').replace("\n", "\\n")
    return '"' + s + '"'


def dump(node, indent=0):
    if isinstance(node, list):
        if not node:
            return "()"
        simple = all(not isinstance(x, list) for x in node)
        if simple:
            return "(" + " ".join(dump(x) for x in node) + ")"
        pad = "\t" * (indent + 1)
        parts = [dump(node[0])]
        out = "(" + parts[0]
        for x in node[1:]:
            if isinstance(x, list):
                out += "\n" + pad + dump(x, indent + 1)
            else:
                out += " " + dump(x)
        out += "\n" + "\t" * indent + ")"
        return out
    if isinstance(node, Sym):
        return str(node)
    if isinstance(node, bool):
        return "yes" if node else "no"
    if isinstance(node, (int, float)):
        return fmt_num(node)
    return q(node)


def fmt_num(v):
    if isinstance(v, int):
        return str(v)
    s = ("%.4f" % v).rstrip("0").rstrip(".")
    return "0" if s in ("-0", "") else s


def find(node, key):
    for x in node:
        if isinstance(x, list) and x and x[0] == key:
            return x
    return None


def find_all(node, key):
    return [x for x in node if isinstance(x, list) and x and x[0] == key]
